kmalhan/ece_470/README.md

# Acceleration Based RC Toy Car Controller

#### Winter 2016 ECE 470 Final Project at Oakland University

#### Contributors
- Kazumi Malhan
- Justen Beffa
