kmalhan/ece_470/Presentation - Acceleration Based RC Toy Car Controller.pdf

# Acceleration RC Car Controller

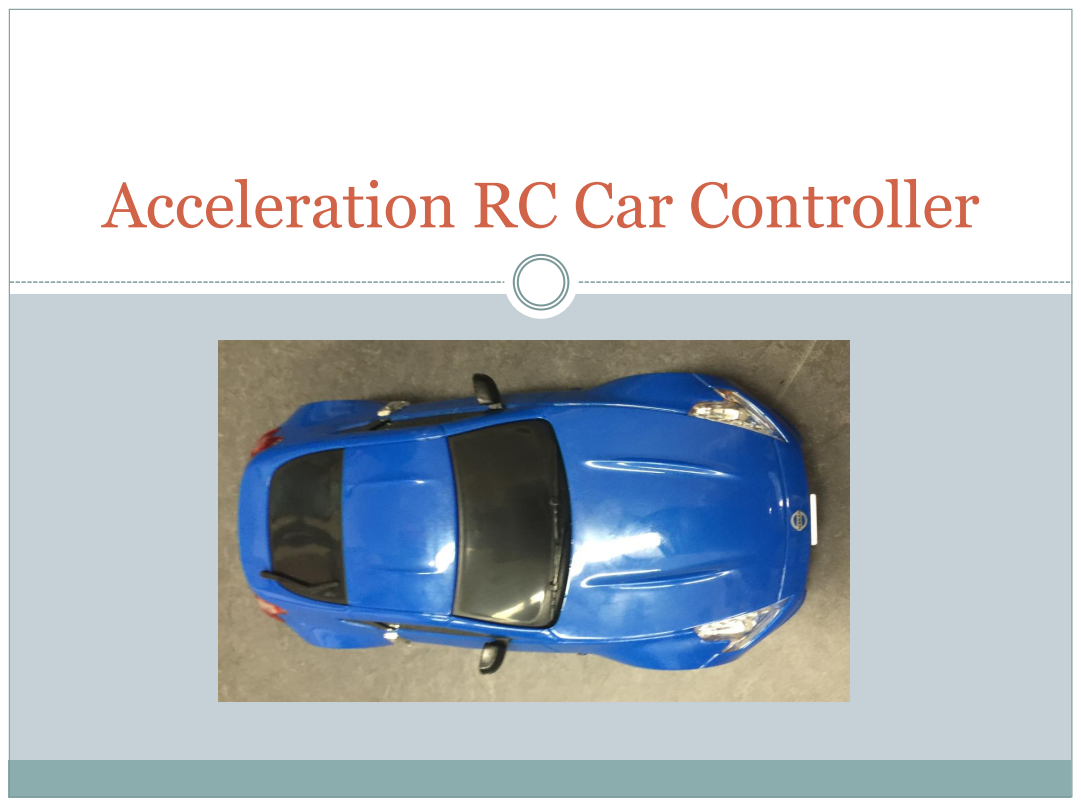
[picture p6: page 1]

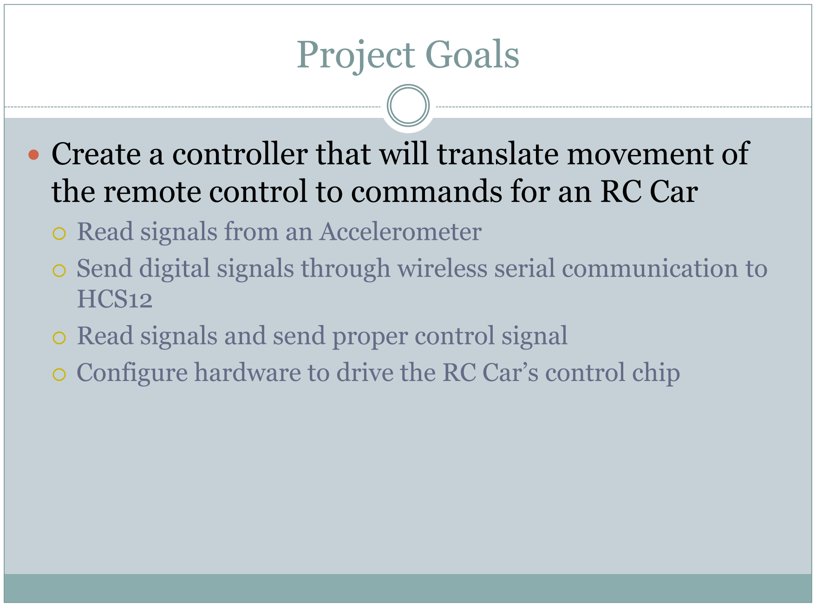
[picture p7: figure]
Project Goals; Read signals from an Accelerometer; HCS12

### - Create a controller that will translate movement of the remote control to commands for an RC Car

- Send digital signals through wireless serial communication to
- Read signals and send proper control signal
- Configure hardware to drive the RC Car’s control chip

## Motion Controller Schematic

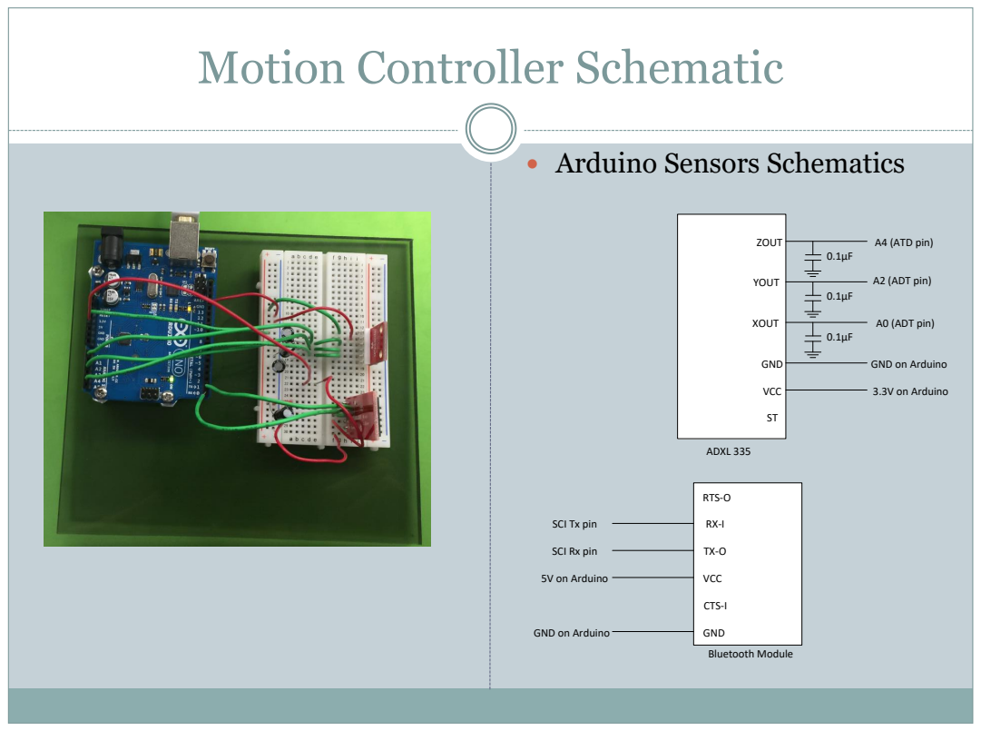
[picture p8: page 3]
ADXL 335; XOUT; YOUT; ZOUT; VCC; GND; A0 (ADT pin) A2 (ADT pin) A4 (ATD pin); CTS-I

Arduino Sensors Schematics

3.3V on Arduino GND on Arduino ST

RTS-O SCI Tx pin SCI Rx pin

GND on Arduino 5V on Arduino

Bluetooth Module VCC

## Reading the Accelerometer

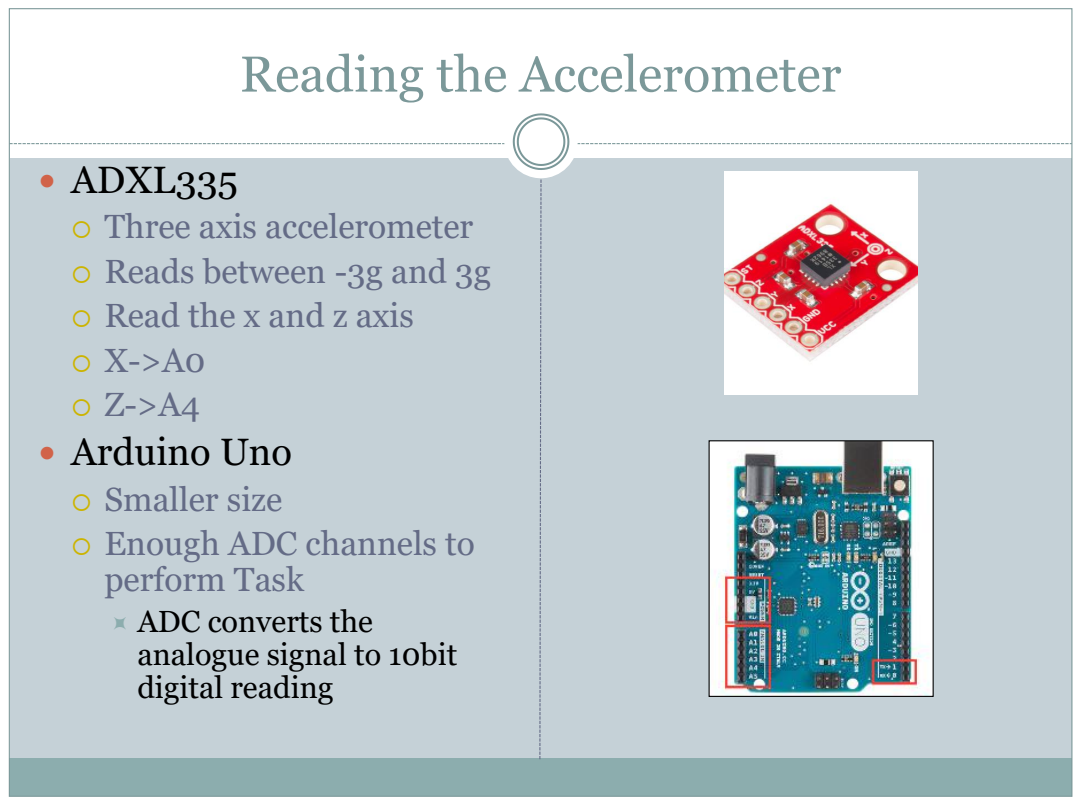
[picture p9: page 4]

ADXL335
Three axis accelerometer
Reads between -3g and 3g
Read the x and z axis
Arduino Uno
Smaller size
Enough ADC channels to
perform Task
ADC converts the
analogue signal to 10bit
digital reading

## Sending Data Serially

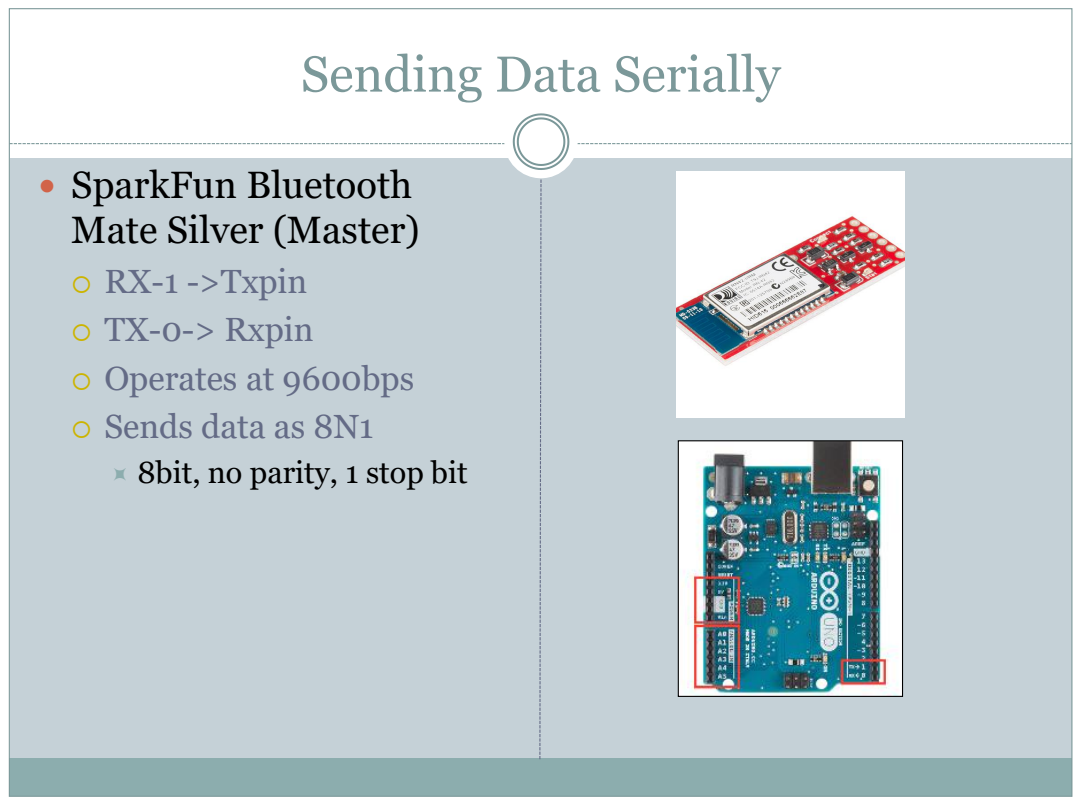
[picture p10: page 5]

SparkFun Bluetooth
Mate Silver (Master)
RX-1 ->Txpin
TX-0-> Rxpin
Operates at 9600bps
Sends data as 8N1
8bit, no parity, 1 stop bit

## Program Running on the Arduino

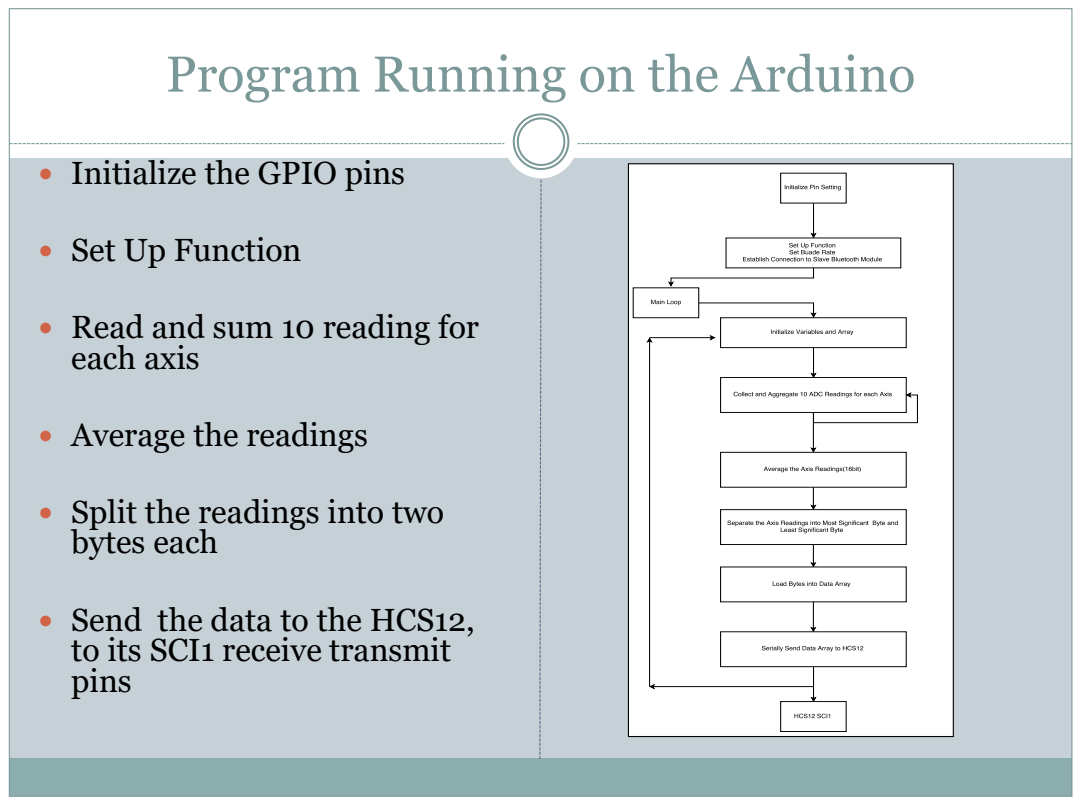
[picture p11: page 6]

Initialize the GPIO pins

Set Up Function

Read and sum 10 reading for
each axis

Average the readings

Split the readings into two
bytes each

Send the data to the HCS12,
to its SCI1 receive transmit
pins

## Toy Controller Schematic

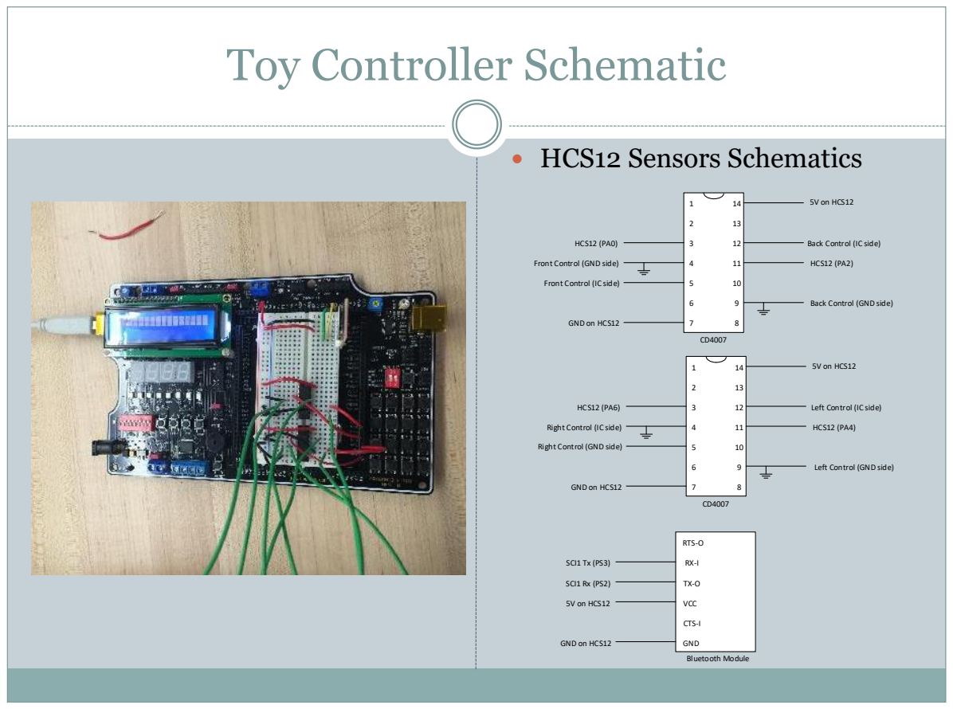
[picture p12: page 7]
HCS12 Sensors Schematics; Bluetooth Module; VCC; GND; CTS-I; RTS-O; SCI1 Tx (PS3); SCI1 Rx (PS2); GND on HCS12; 5V on HCS12; HCS12 (PA4); HCS12 (PA6); HCS12 (PA2); HCS12 (PA0)

Back Control (IC side)

Front Control (GND side)

Front Control (IC side)

Back Control (GND side)

Left Control (IC side)

Right Control (IC side)

Right Control (GND side)

Left Control (GND side)

## Receiving Data Serially

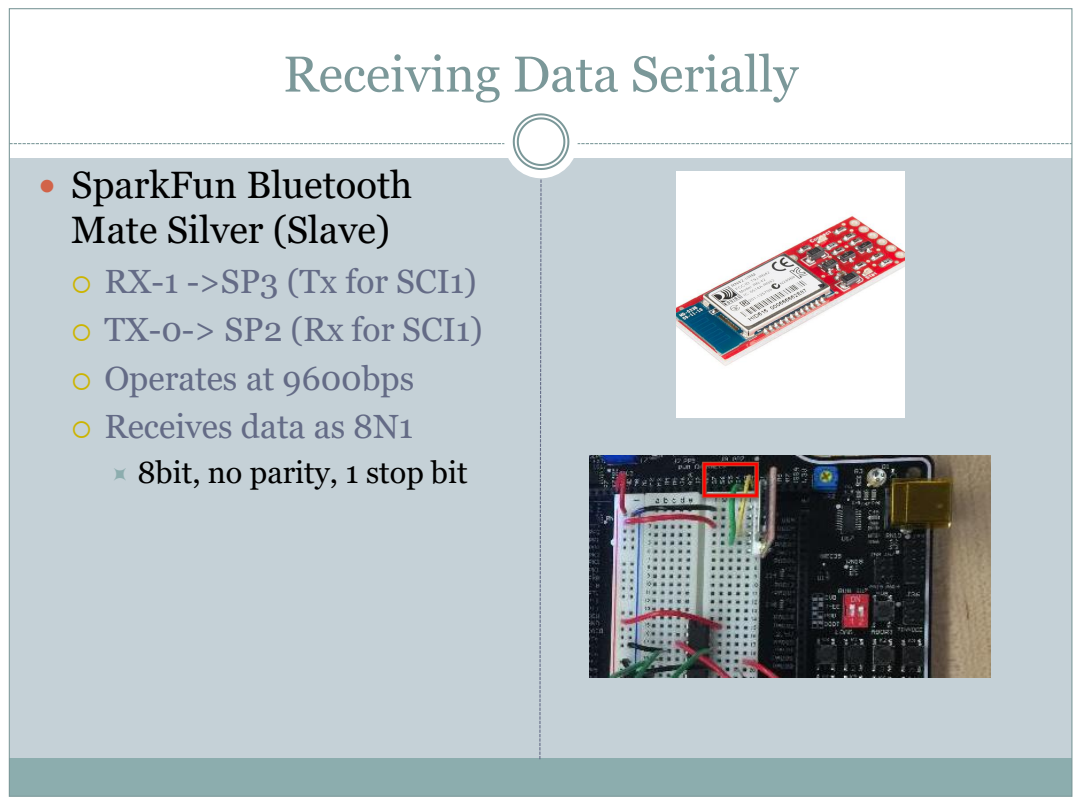
[picture p13: page 8]

SparkFun Bluetooth
Mate Silver (Slave)
RX-1 ->SP3 (Tx for SCI1)
TX-0-> SP2 (Rx for SCI1)
Operates at 9600bps
Receives data as 8N1
8bit, no parity, 1 stop bit

## Sending Control Signal

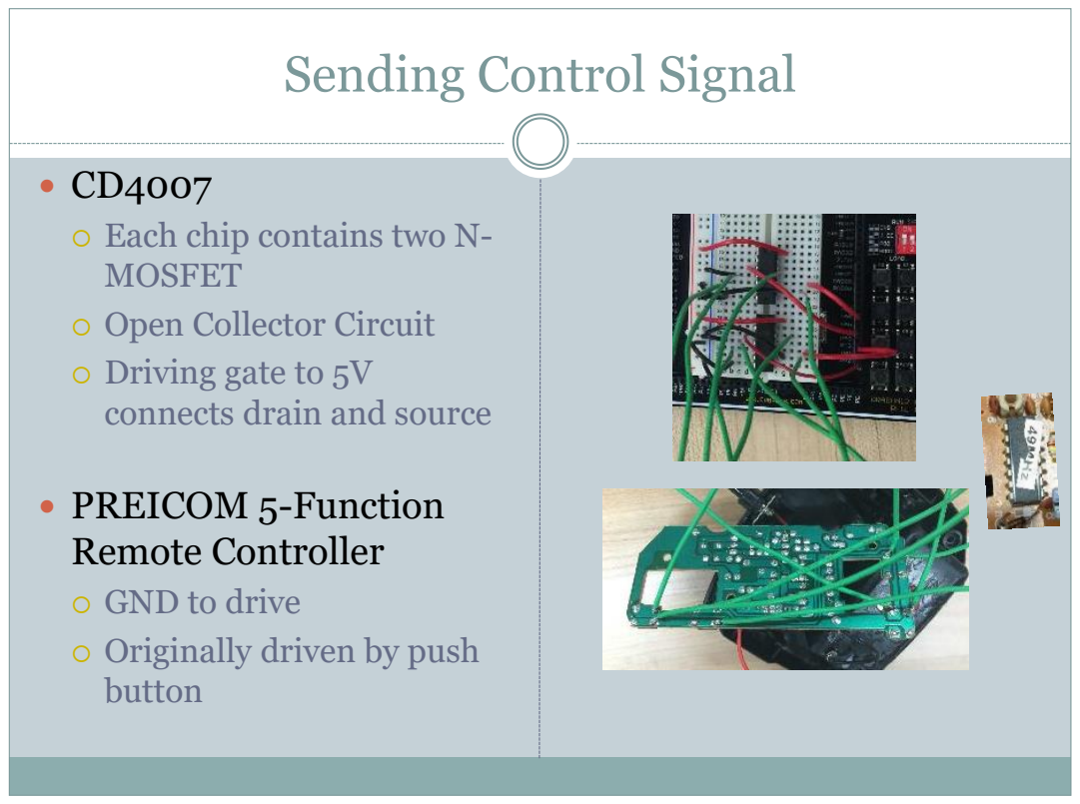
[picture p14: page 9]

Each chip contains two N-
MOSFET
Open Collector Circuit
Driving gate to 5V
connects drain and source

PREICOM 5-Function
Remote Controller
GND to drive
Originally driven by push
button

## Program Running on the HCS12

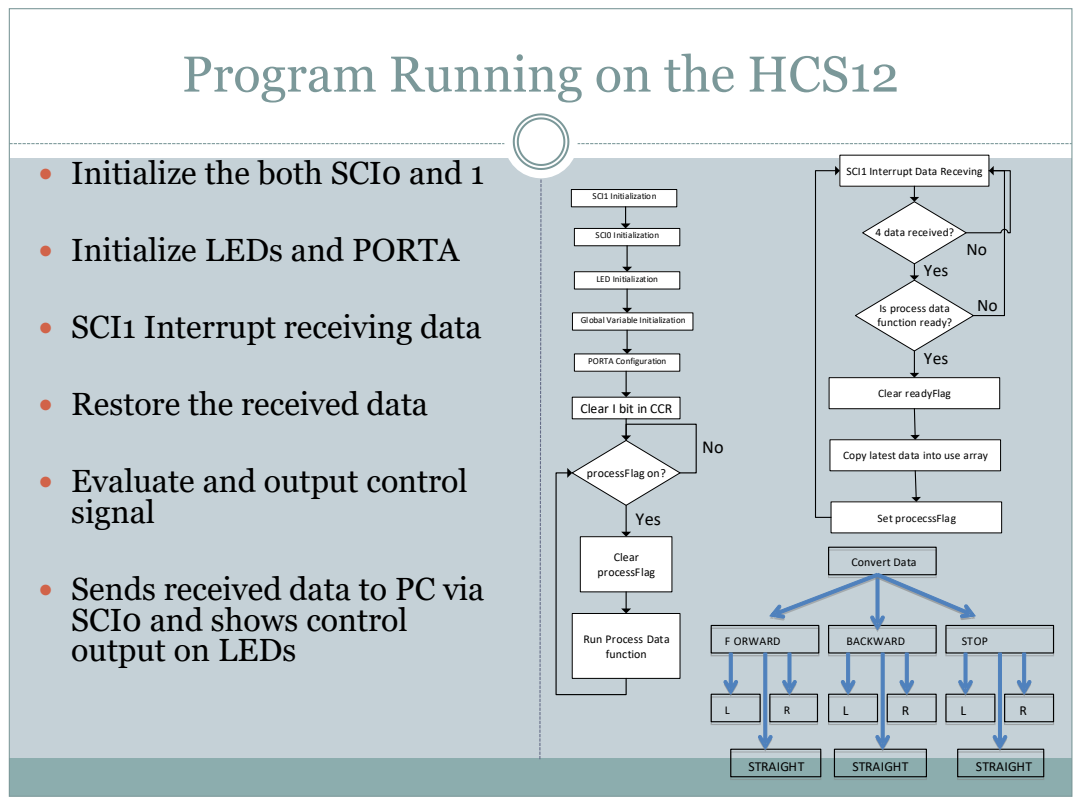
[picture p15: page 10]
SCI1 Initialization; SCI0 Initialization; LED Initialization; PORTA Configuration; processFlag on?; Clear processFlag; Yes; 4 data received?; Clear readyFlag; Set procecssFlag; No F ORWARD; BACKWARD; STOP; STRAIGHT; Convert Data

Initialize the both SCI0 and 1

SCI1 Interrupt Data Receving

Initialize LEDs and PORTA

SCI1 Interrupt receiving data

Is process data
function ready?
Yes

Global Variable Initialization

Restore the received data

Clear I bit in CCR

Copy latest data into use array

Evaluate and output control
signal

Sends received data to PC via
SCI0 and shows control
output on LEDs

Run Process Data
function

## Conclusion

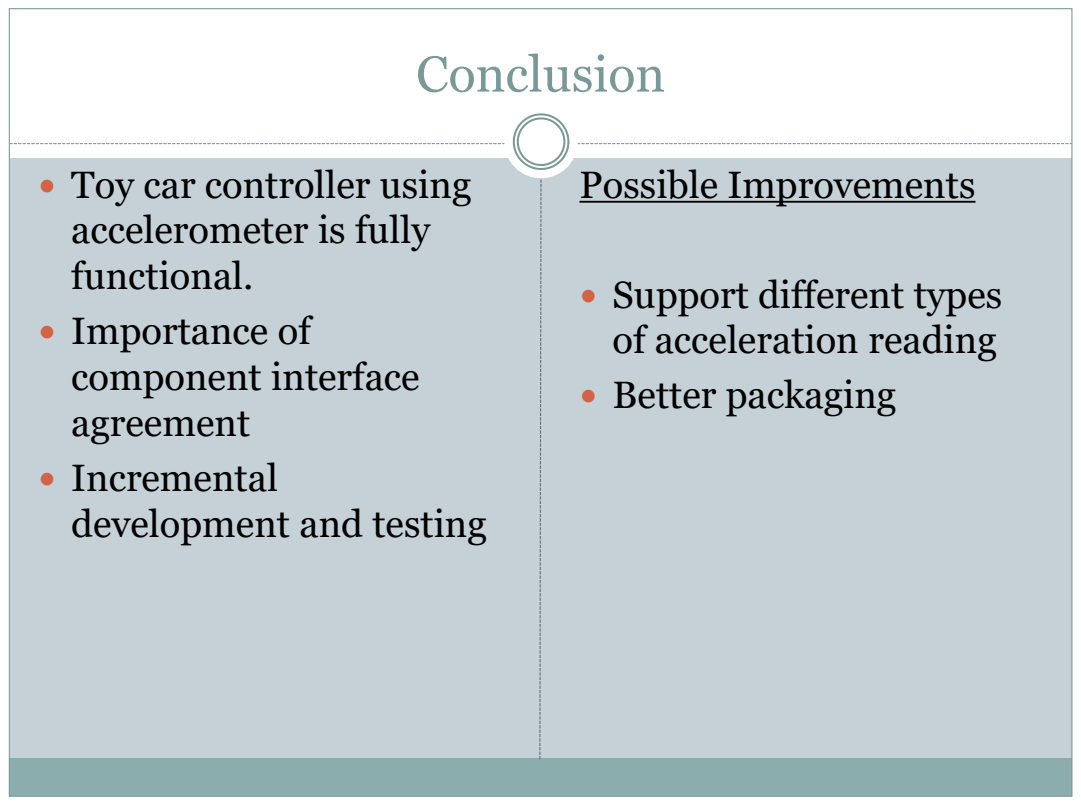
[picture p16: page 11]
Possible Improvements

Toy car controller using
accelerometer is fully
functional.
Importance of
component interface
agreement
Incremental
development and testing

Support different types
of acceleration reading
Better packaging
