kmalhan/ece_470/HCS12_Code/Sources/led.h

/* LED Interface Header */

// Initialize LEDs
void LEDs_init(void);

// Switch on LEDs
void LED_on(int led_num);

// Switch off LEDs
void LED_off(int led_num);

// Toggle LEDs
void LED_toggle(int led_num);
